gciurpita/Koala/Docs/Images/js_pcb.jpg

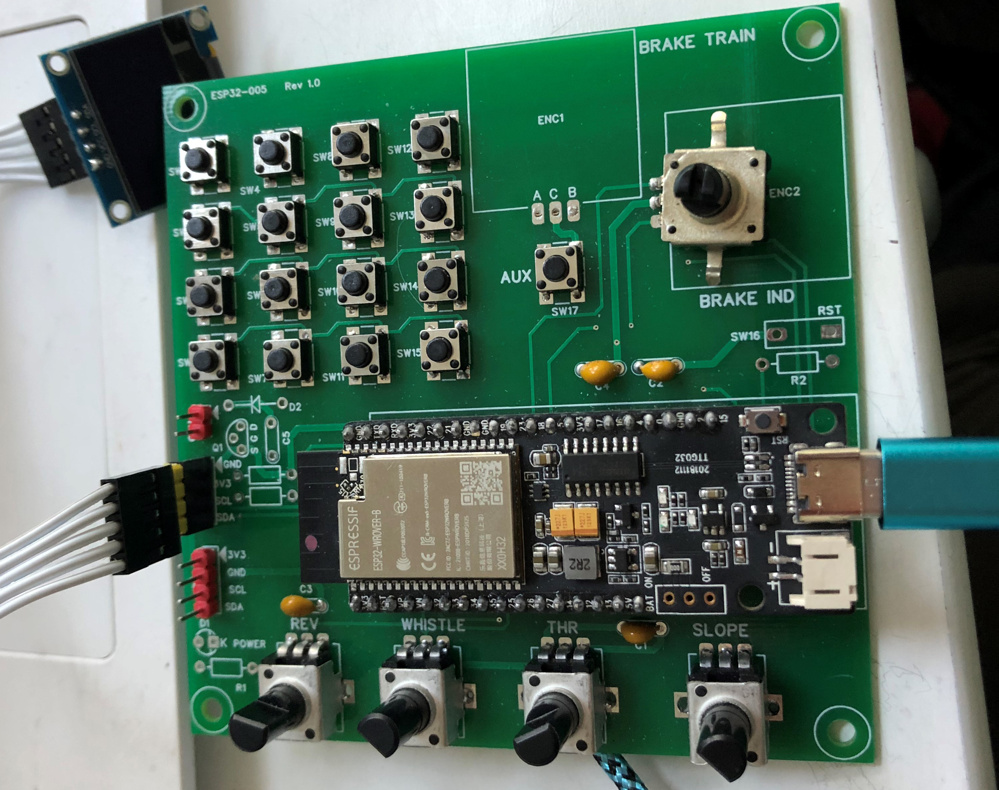
Docs/Images/js_pcb.jpg
