gciurpita/Koala/eng.h

#ifndef LOCOS_H
# define LOCOS_H

#define WHYTE_LEN   10
#define LOCO_LEN    20

#define N_ENG       20

struct Eng_s {
    float  drvrDia;
    float  cylDia;
    float  cylStr;
    int    numCyl;

    int    PSI;
    int    wtAdh;
    int    wtLoco;
    int    wtTndr;

    float  grate;       // unused
    float  blrLen;      // unused
    float  blrDia;      // unused
    float  blrVol;      // unused

    float  pipeDia;
        
    char   whyte [WHYTE_LEN];
    char   name  [LOCO_LEN];
};

// -------------------------------------
extern Eng_s engs [];

extern Eng_s   *pEng;

// -----------------------------------------------
void    engDisp (Eng_s *p);
char    engEdit (Eng_s *p, const char *desc);
int     engGet  (char* name);

#endif
