gciurpita/Koala/(commit log)

2021-03-02 integrated brakes, engine and loco code compiles
2021-03-06 added reset (R) and file deletion (X) commands
    [pcRead.cpp]
2021-03-16 replaced loco w/ locoIdx and use Loco_t
    [Koala.ino, engine.cpp, pcRead.cpp, physics.cpp, vars.cpp, vars.h]
2021-03-20 use printf
2021-03-20 replace EeVars with cfg but needs work
    [pcRead.cpp]
2021-03-20 replaced _cfgMode with use of cfgEdit()
    [pcRead.cpp]
2021-03-20 add debug, replace wtLoco with pEng->wtLoco
    [physics.cpp]
2021-03-23 added brake states to display
2021-03-23 made sure each entry has valid throttle pipe diameter
2021-03-23 add DBG_CYLPRESS and fixed other debug
    [engine.cpp]
2021-03-23 corrected tonnage calc and handling initial msec > 1 sec value
    [physics.cpp]
2021-03-24 added limit preventing negative fill and density
    [engine.cpp]
2022-06-05 add OvrFlow strings, stepsPerDetect=2, +struct Enc to handle encoder range
2022-06-05 fix disp of <0 vals, correct sum fo forces, recognize mph == 0
    [physics.cpp]
2022-06-07 corrected throttle computation
2022-06-07 added JMRI abort button & cleaned up initializing state
2022-06-08 correct handling menu mode, defeated reading EEPROM, add hostname
    [Koala.ino]
2022-06-12 fix mass of cars, missing LbTton
    [physics.cpp]
2022-06-12 added Board1 to handle stepsPerDetent and Ind encoder direction
2022-06-13 corrected menus to change address, locoIdx and added cars
    [Koala.ino]
2022-06-13 update ReadMe.md providing overview of what throttle is
2022-07-01 change max brake pct based on max cyl psi & set REL fil rate to 1
2022-07-02 add plot relating brake line pressure and braking force
2022-08-28 made timer >= to gne output at 1 sec interval
2022-09-18 add brake stopping time/distance
2023-02-13 direction fixes and seeing !0 drawbar force after thr closed
    [Koala.ino, koala.h, physics.cpp, vars.cpp, vars.h]
2023-02-13 prevent consume being negative
    [engine.cpp]
2023-02-15 add links to docs and add call flow to theory doc
2023-02-16 include loco when air brakes applied and corrected unnecesary conversion of wtTot to lbs
    [brakes.cpp, physics.cpp]
2023-02-16 replace images showing independent & air brakes in loco
